PandiLog/Quantum-Racing-FEA/Validación y Optimización Estructural_ Extensión de Dirección.pdf

### Validación y Optimización Estructural: Extensión de

### Dirección

Galo Aréchiga Gutiérrez

### 18 de febrero del 2025

Resumen:
Se evaluaron tres configuraciones para la nueva extensión del steering knuckle. Tras un análisis comparativo de FEA y manufacturabilidad, se seleccionó el diseño de 90mm como la solución final. A pesar de ser la opción más compacta, garantiza un FOS de 2.42, reduce la complejidad a una sola pieza sólida y minimiza el peso del ensamble, superando a la configuración inicial de 110mm V1.

Problemas y Objetivos:

Contexto: El brazo de dirección original se encontraba desprendido; se requería una extensión diseñada desde cero para recuperar la funcionalidad del sistema.

Objetivo: Determinar la geometría óptima que equilibre seguridad estructural (FOS > 2.0), bajo peso y facilidad de manufactura.

Criterios de selección:

Característica | 110mm V1 (Prototipo Inicial) Figura 1 | 110mm V2 Figura 2 | 90mm (Diseño Final) Figura 3 | Ventaja del Ganador
Complejidad | 3 Piezas (Ensamble) | 3 Piezas (Ensamble) | 1 Pieza (Monolítica) | Menos puntos de falla
Peso (kg) | 0.044 | 0.088 | 0.033 | Mejora dinámica del vehículo

Esfuerzo Máximo | 574.918 | 140.018 | 242.022 | Dentro del límite elástico
Manufactura | Más puntos de soldadura | Más puntos de soldadura | Puntos de soldadura mínimos | Reducción de costos/tiempo

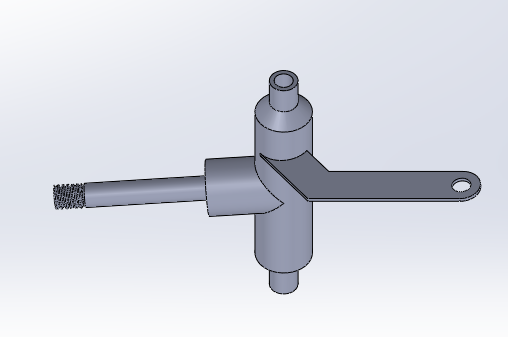
[picture p1: figure]

Figura 3 (90mm)

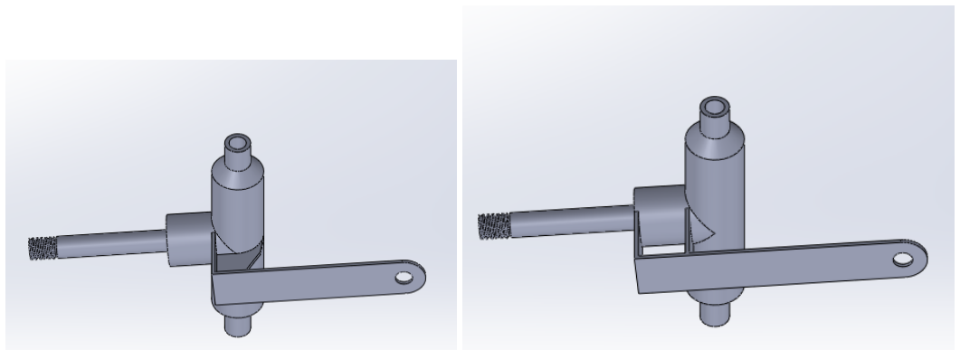
[picture p2: figure]

Figura 2 (110mm V2) | Figura 1(110mm V1)

Análisis de Resultados (FEA) (Post-processing Python):

Metodología del Análisis:
Software: SolidWorks Simulation (FEA) + Python (Post-procesamiento). Material: Steel 9840 (585 MPa)
Criterio de Falla: Von Mises

Definición de Casos de Carga (Worst-Case Scenario):

Para la validación por elementos finitos (FEA), se definió un escenario de carga crítica basado en el bloqueo de neumáticos durante un frenado dinámico máximo. Considerando una masa de 160 kg y una transferencia de carga al eje delantero del 70%, se determinó un torque de frenado de 104.7 N*m por rueda. Para la geometría seleccionada de 90 mm, esto se traduce en una fuerza axial de 1163 N (951 N, respectivamente para las otras dos configuraciones), la cual fue aplicada como condición de frontera en los análisis de tensión y compresión.

Matriz de Decisión Estructural:

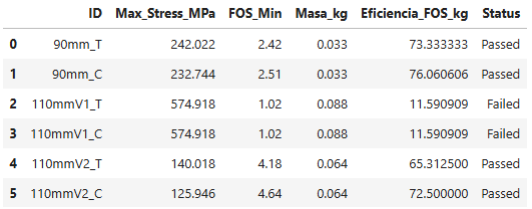
[picture p3: figure]

Distribución de esfuerzos dentro del barreno (Inner Bearing)

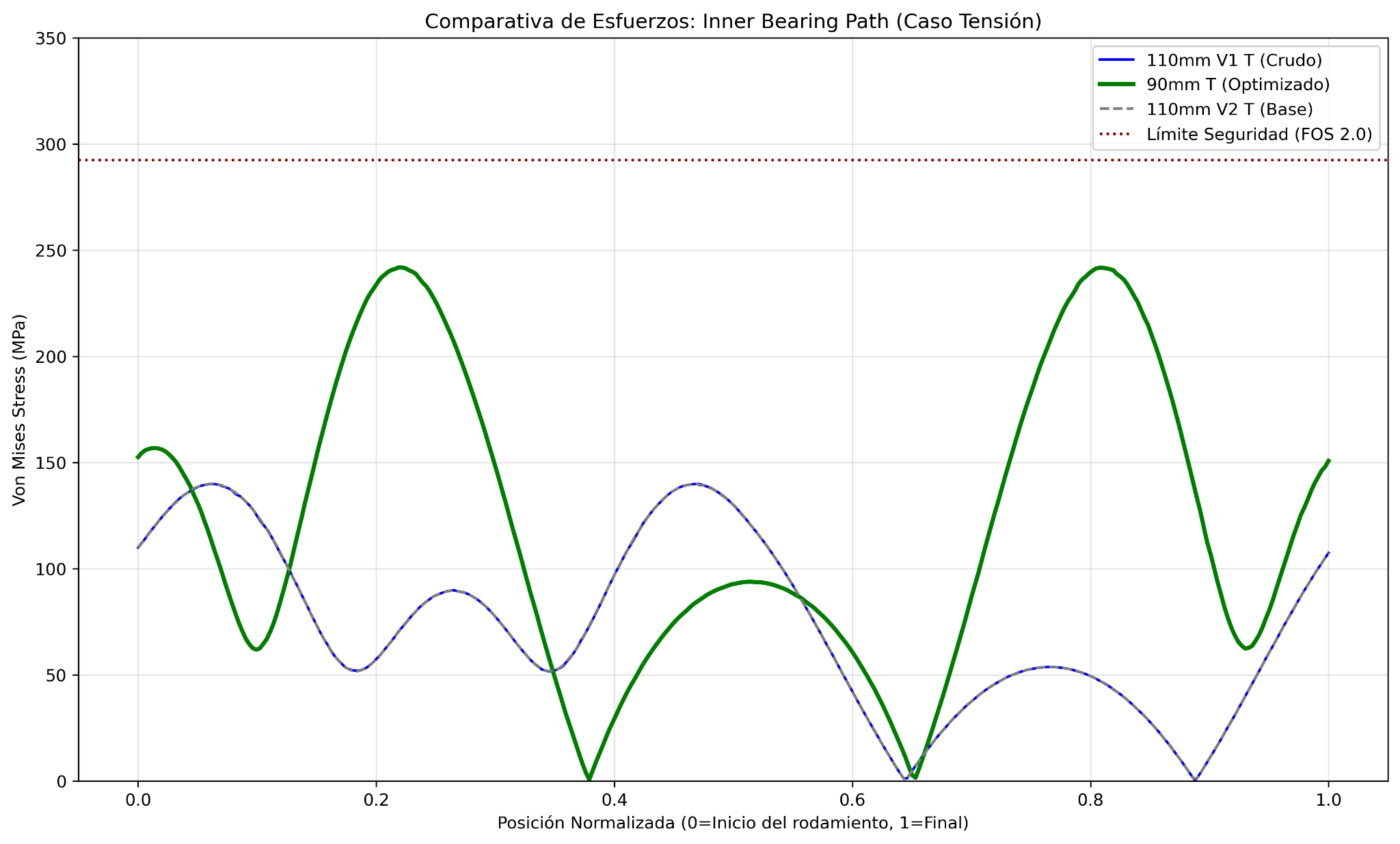
[picture p4: figure]
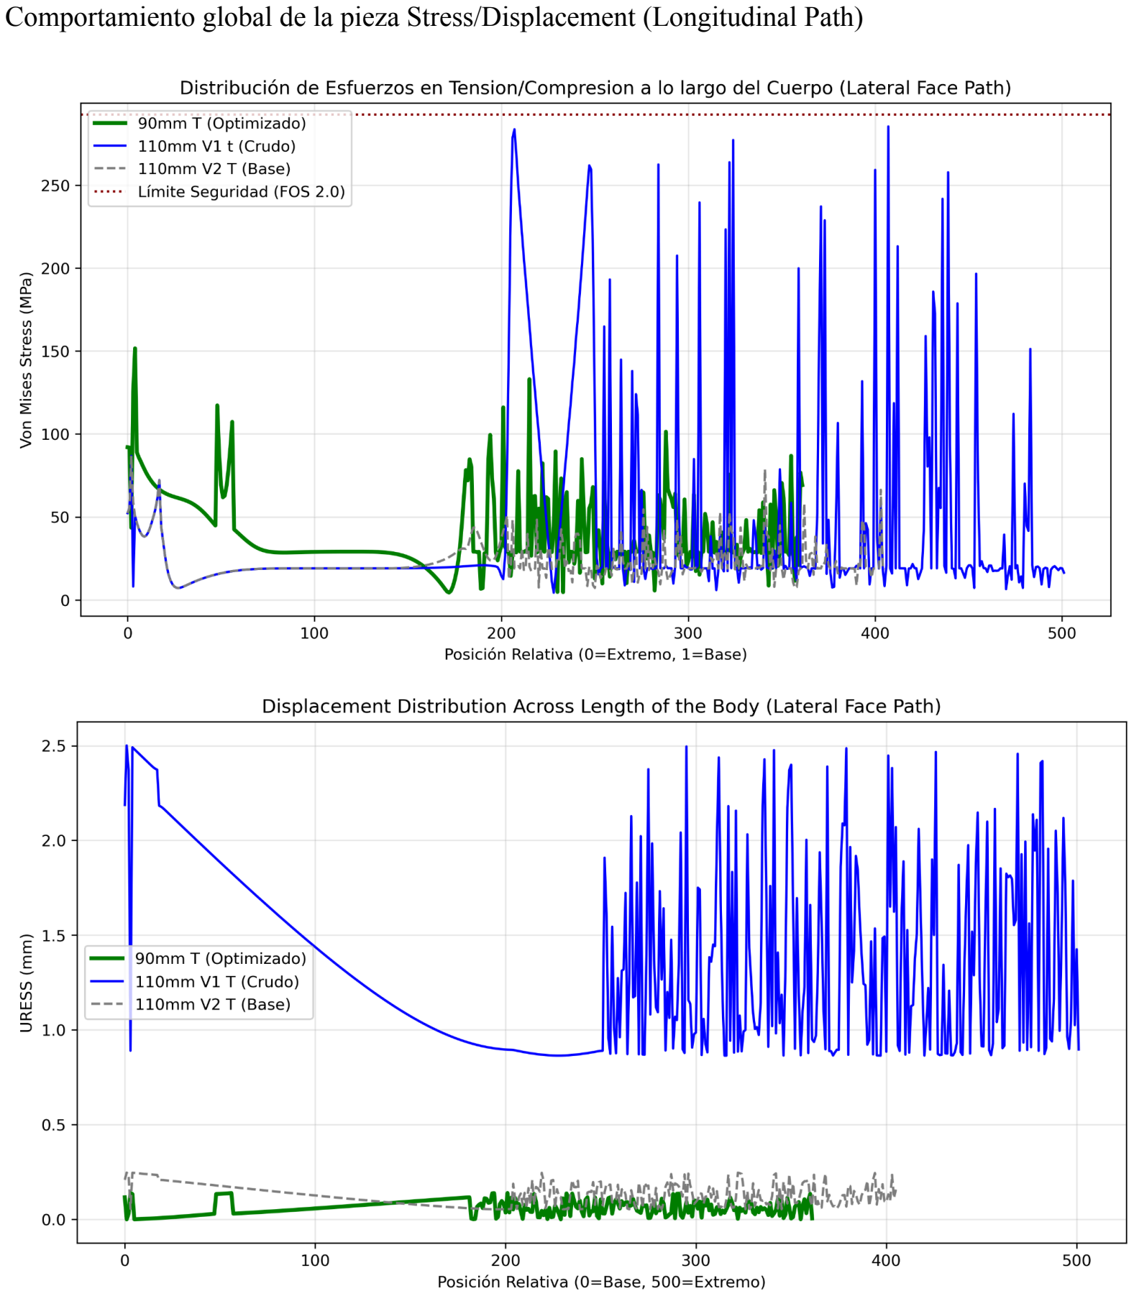
[picture p5: page 6]

Comportamiento global de la pieza Stress/Displacement (Longitudinal Path)

Cuantificación de mejora (110mm V1 vs. 90mm)

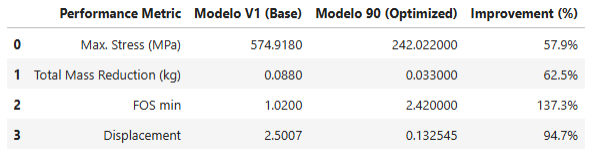
[picture p6: figure]

Conclusión

El diseño de 90mm se ratifica como la configuración óptima. Proporciona la rigidez necesaria

para soportar las cargas de frenado de 1163 N minimizando el peso de la pieza. Su arquitectura

de una sola pieza simplifica su manufactura y al necesitar menos puntos de soldadura aumenta la

confiabilidad del sistema de dirección bajo condiciones de competencia.
