PandiLog/Quantum-Racing-FEA/cad/OP2.SLDPRT

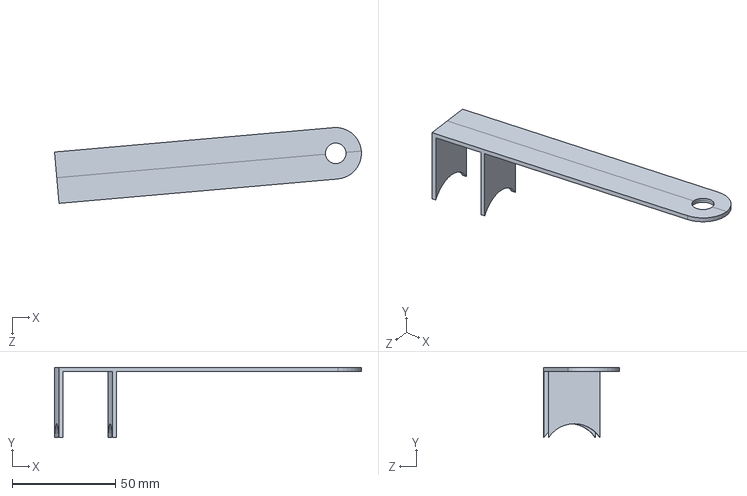
[picture p7: CAD file, 2026-02-19]
cad/OP2.SLDPRT
148.9 x 34.0 x 36.7 mm
