PandiLog/Quantum-Racing-FEA/cad/OP3.SLDPRT

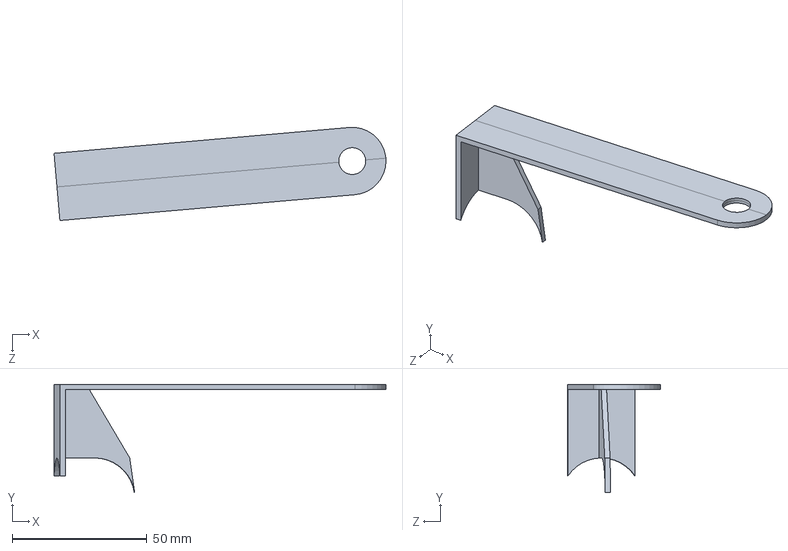
[picture p8: CAD file, 2026-02-19]
cad/OP3.SLDPRT
123.0 x 40.2 x 34.5 mm
