PandiLog/Quantum-Racing-FEA/cad/OP1.SLDPRT

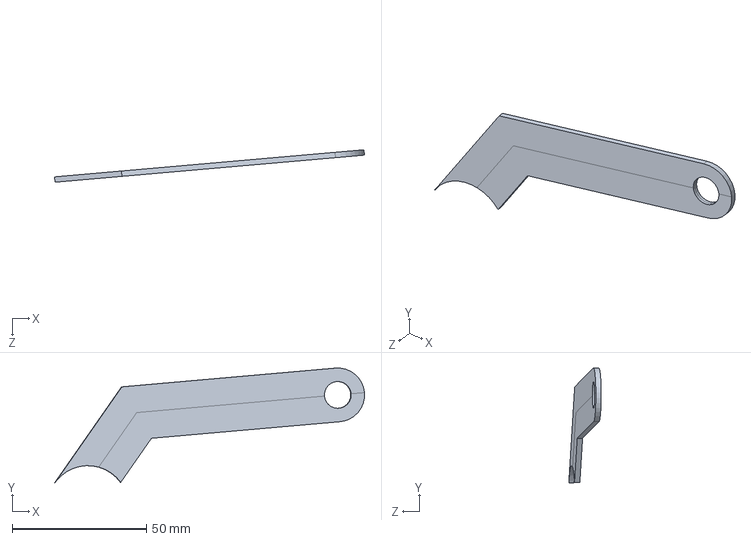
[picture p9: CAD file, 2026-02-19]
cad/OP1.SLDPRT
115.3 x 42.7 x 12.1 mm
