PandiLog/Quantum-Racing-FEA/cad/masa con direccion quantum.SLDPRT

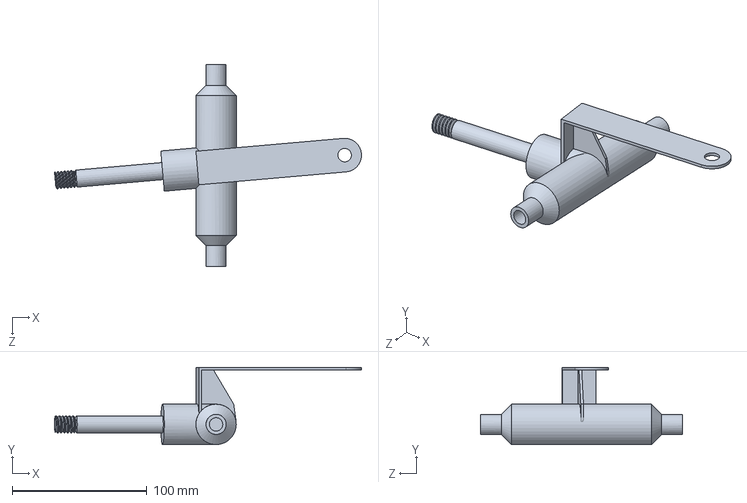
[picture p10: CAD file, 2026-02-19]
cad/masa con direccion quantum.SLDPRT
228.1 x 57.3 x 150.0 mm
