PandiLog/Quantum-Racing-FEA/results/Analisis_Estructural_Direccion.xlsx

Sheet: Matriz_Decision
Max_Stress_MPa | Max_Displ_mm | FOS_Min | Status | Masa_kg | ID | Eficiencia_FOS_kg
242.022 | 0.132545 | 2.42 | Passed | 0.033 | 90mm_T | 73.33333333
232.744 | 0.397898 | 2.51 | Passed | 0.033 | 90mm_C | 76.06060606
574.918 | 2.5007 | 1.02 | Failed | 0.088 | 110mmV1_T | 11.59090909
574.918 | 2.49442 | 1.02 | Failed | 0.088 | 110mmV1_C | 11.59090909
140.018 | 0.246592 | 4.18 | Passed | 0.064 | 110mmV2_T | 65.3125
125.946 | 0.240399 | 4.64 | Passed | 0.064 | 110mmV2_C | 72.5

Sheet: Cuantificacion_Mejoras
Performance Metric | Modelo V1 (Base) | Modelo 90 (Optimized) | Improvement (%)
Max. Stress (MPa) | 574.918 | 242.022 | 57.9%
Total Mass Reduction (kg) | 0.088 | 0.033 | 62.5%
FOS min | 1.02 | 2.42 | 137.3%
Displacement | 2.5007 | 0.132545 | 94.7%
