PandiLog/Quantum-Racing-FEA/results/Displacement Distribution.png

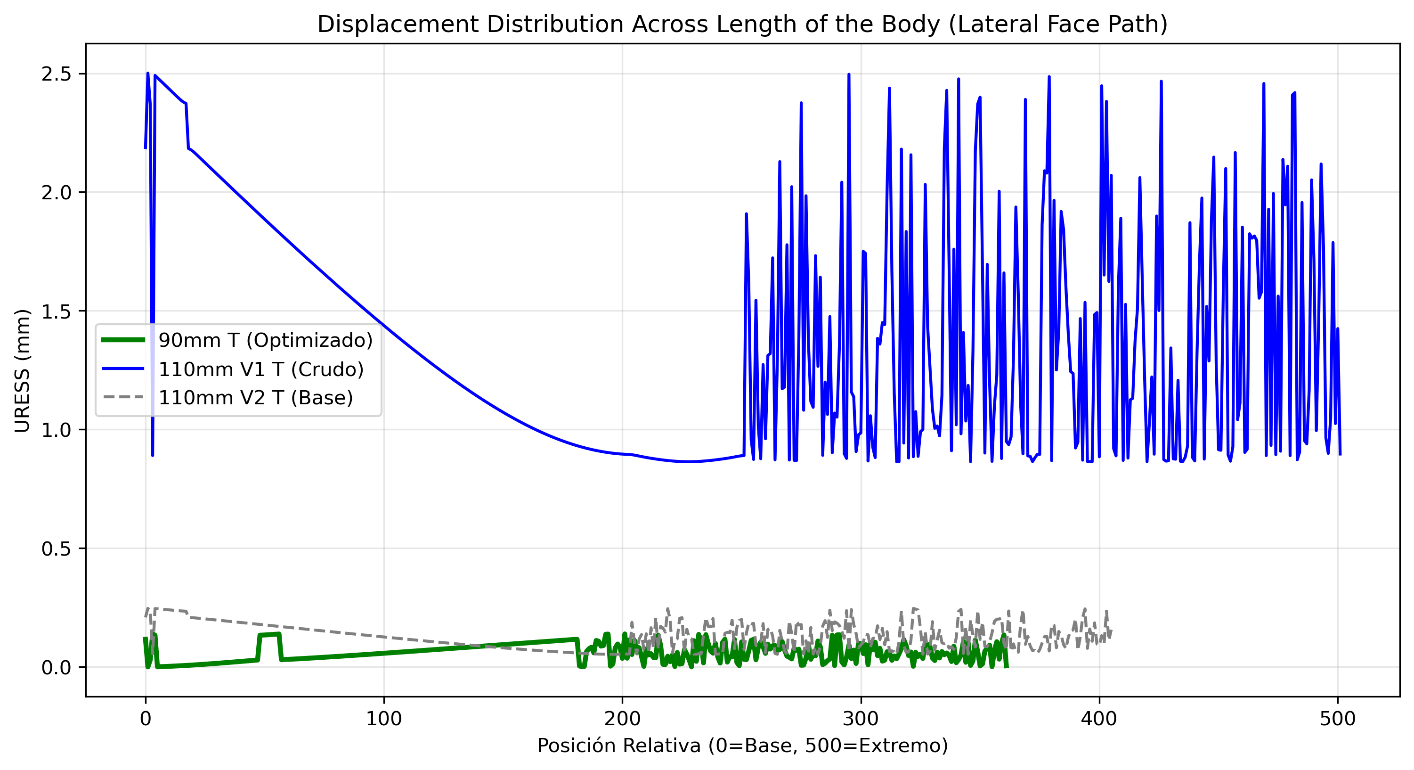
results/Displacement Distribution.png
