PandiLog/Quantum-Racing-FEA/results/Distribución de Esfuerzos.png

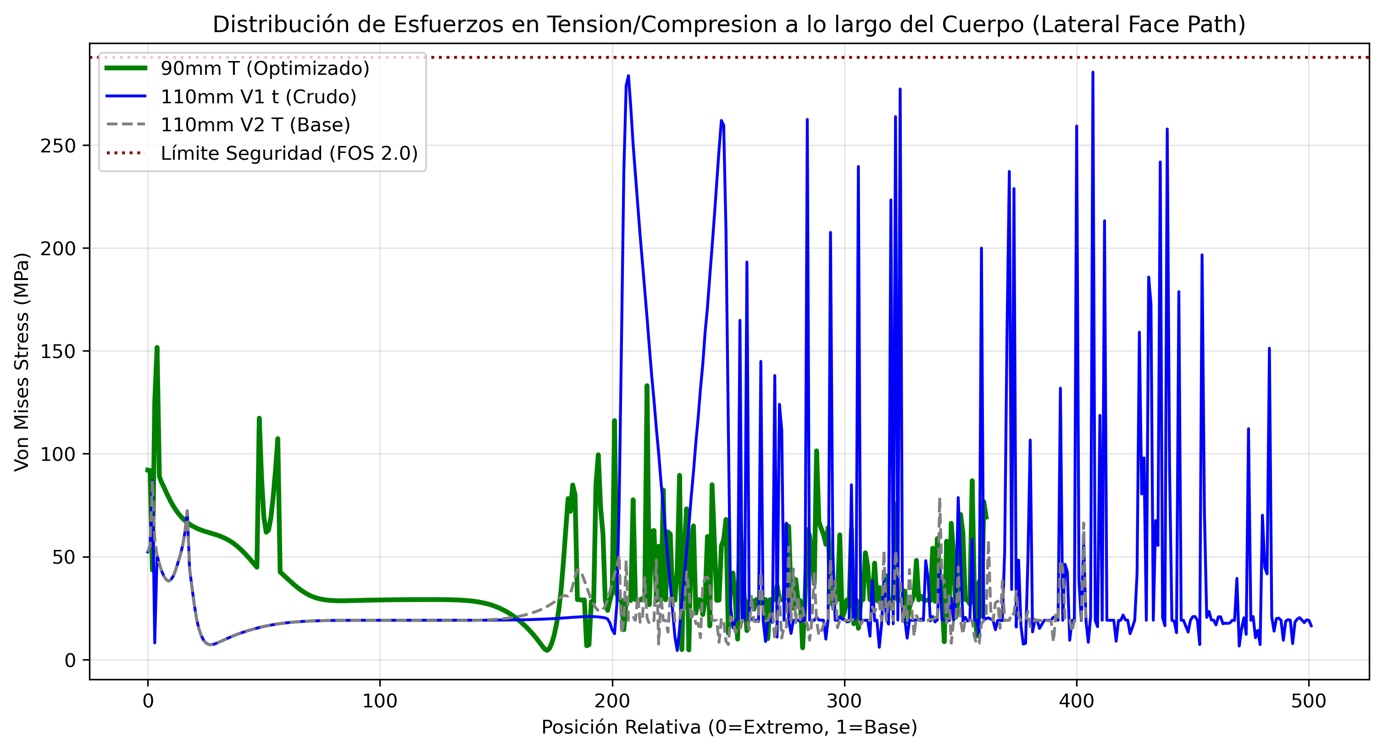
results/Distribución de Esfuerzos.png
